LukaszWolf/Meteo-station-with-AWS-Cloud-5-semester-project-/docs/photos/IMG_20260125_191320.jpg

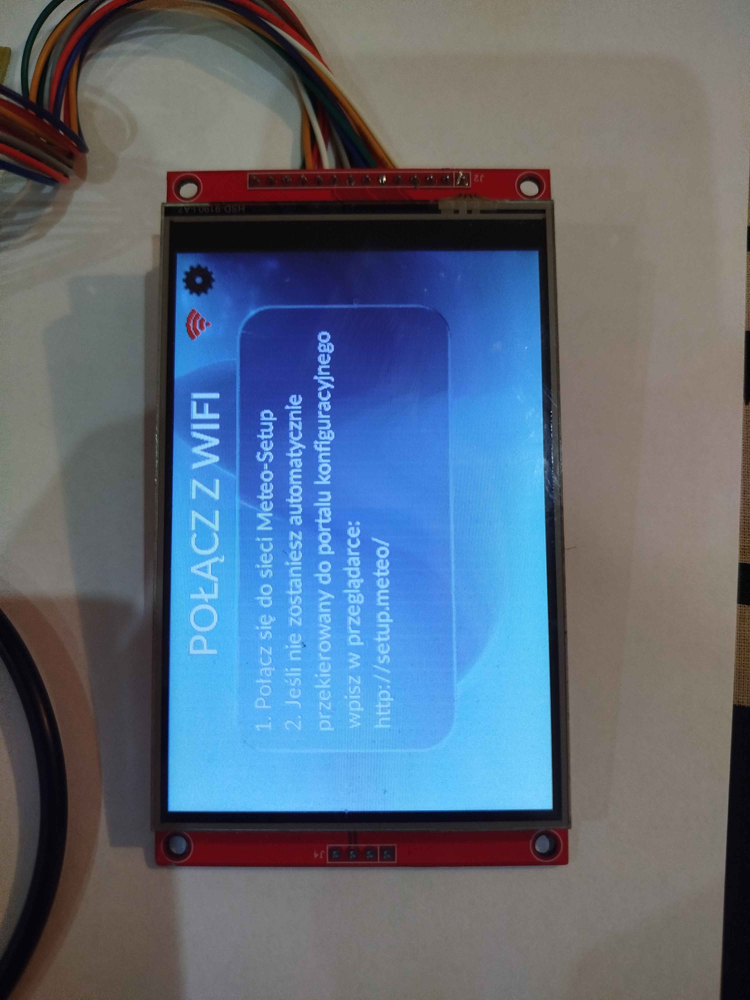
docs/photos/IMG_20260125_191320.jpg
