LukaszWolf/Meteo-station-with-AWS-Cloud-5-semester-project-/code/indoor module/data/images/app-connecting-screen-min.png

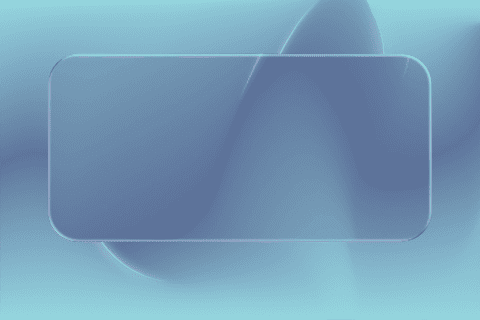
code/indoor module/data/images/app-connecting-screen-min.png
