LukaszWolf/Meteo-station-with-AWS-Cloud-5-semester-project-/code/indoor module/data/images/main_screen-min.png

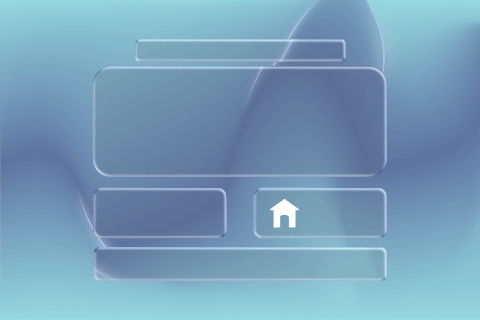
code/indoor module/data/images/main_screen-min.png
