LukaszWolf/Meteo-station-with-AWS-Cloud-5-semester-project-/code/indoor module/data/images/settings_screen-min.png

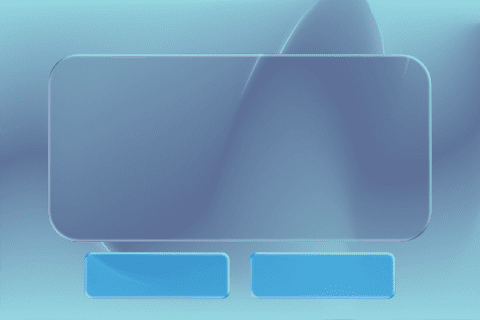
code/indoor module/data/images/settings_screen-min.png
