LukaszWolf/Meteo-station-with-AWS-Cloud-5-semester-project-/docs/photos/1769365940309.jpg

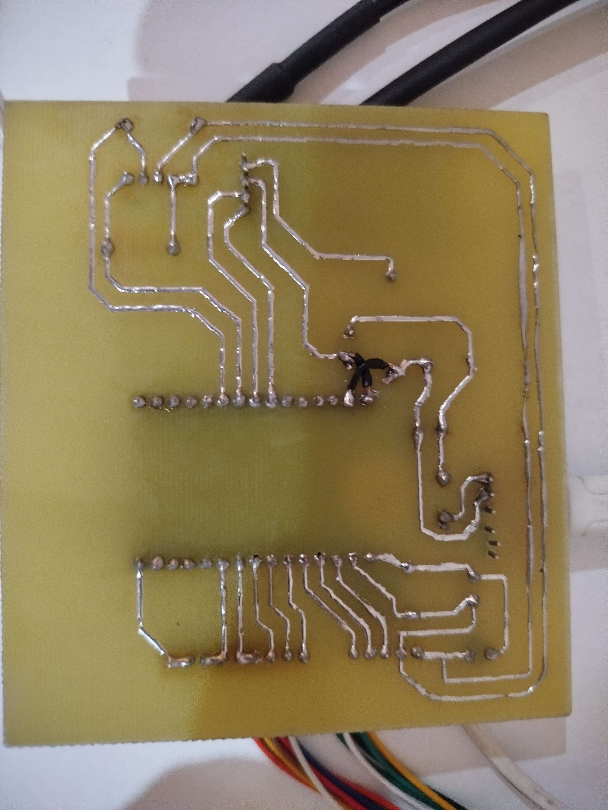
docs/photos/1769365940309.jpg
