LukaszWolf/Meteo-station-with-AWS-Cloud-5-semester-project-/docs/photos/IMG_20260125_190333.jpg

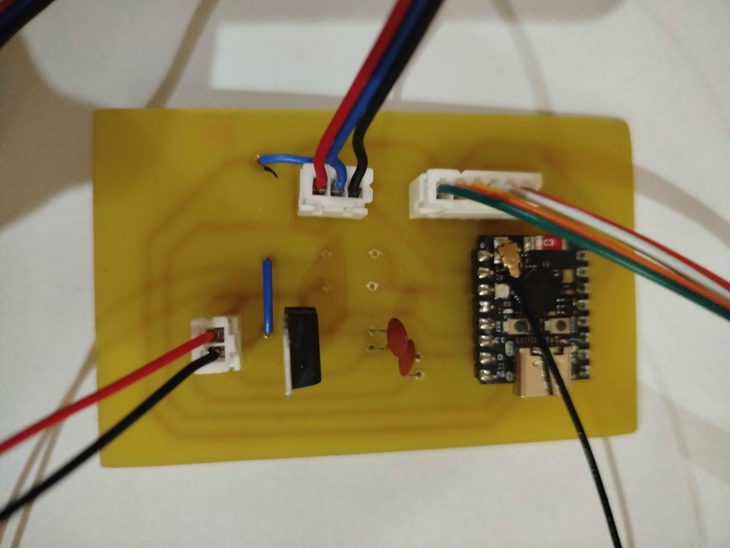
docs/photos/IMG_20260125_190333.jpg
