LukaszWolf/Meteo-station-with-AWS-Cloud-5-semester-project-/docs/photos/Zrzut ekranu 2026-01-25 192426.png

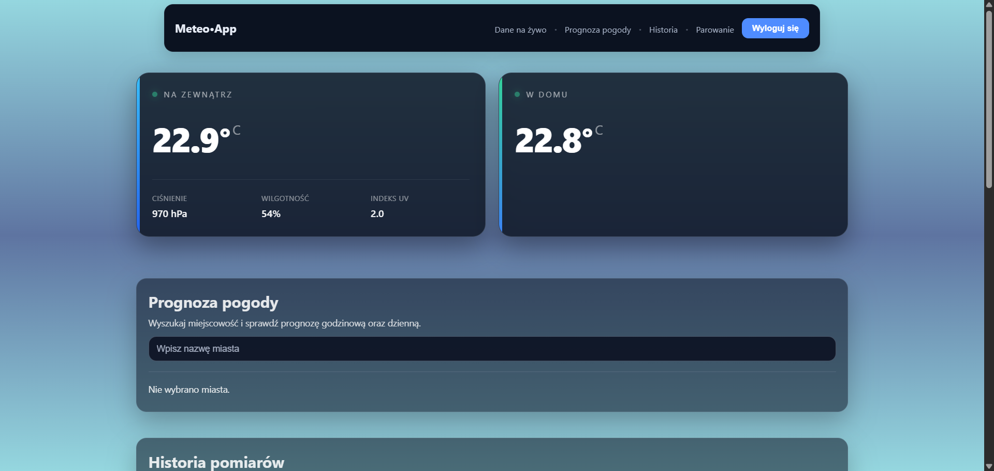
docs/photos/Zrzut ekranu 2026-01-25 192426.png
