LukaszWolf/Meteo-station-with-AWS-Cloud-5-semester-project-/docs/schemat ideowy modułu zewnętrznego.pdf

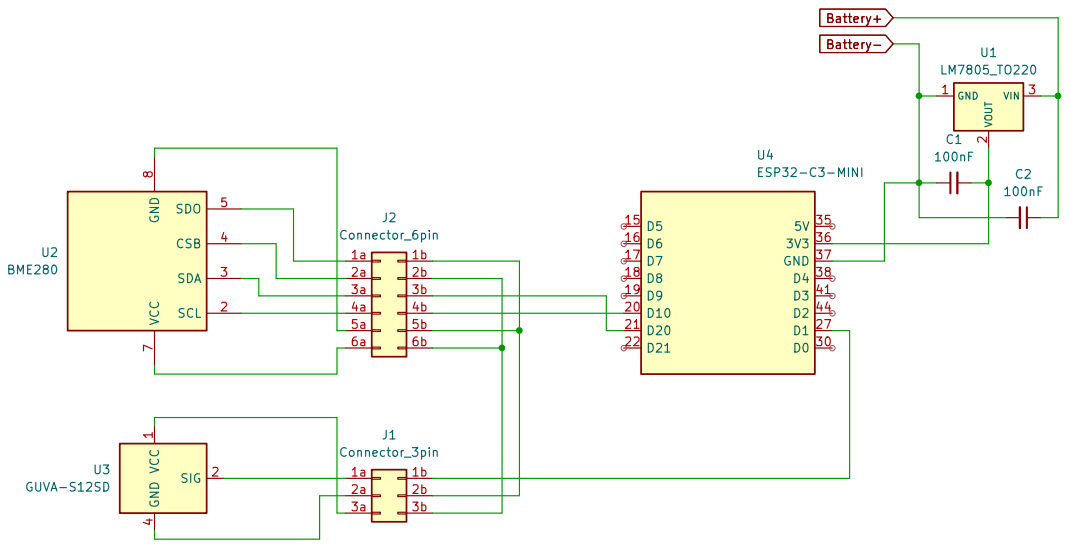
[picture p31: page 1]
