LukaszWolf/Meteo-station-with-AWS-Cloud-5-semester-project-/docs/schemat ideowy stacji domowej.pdf

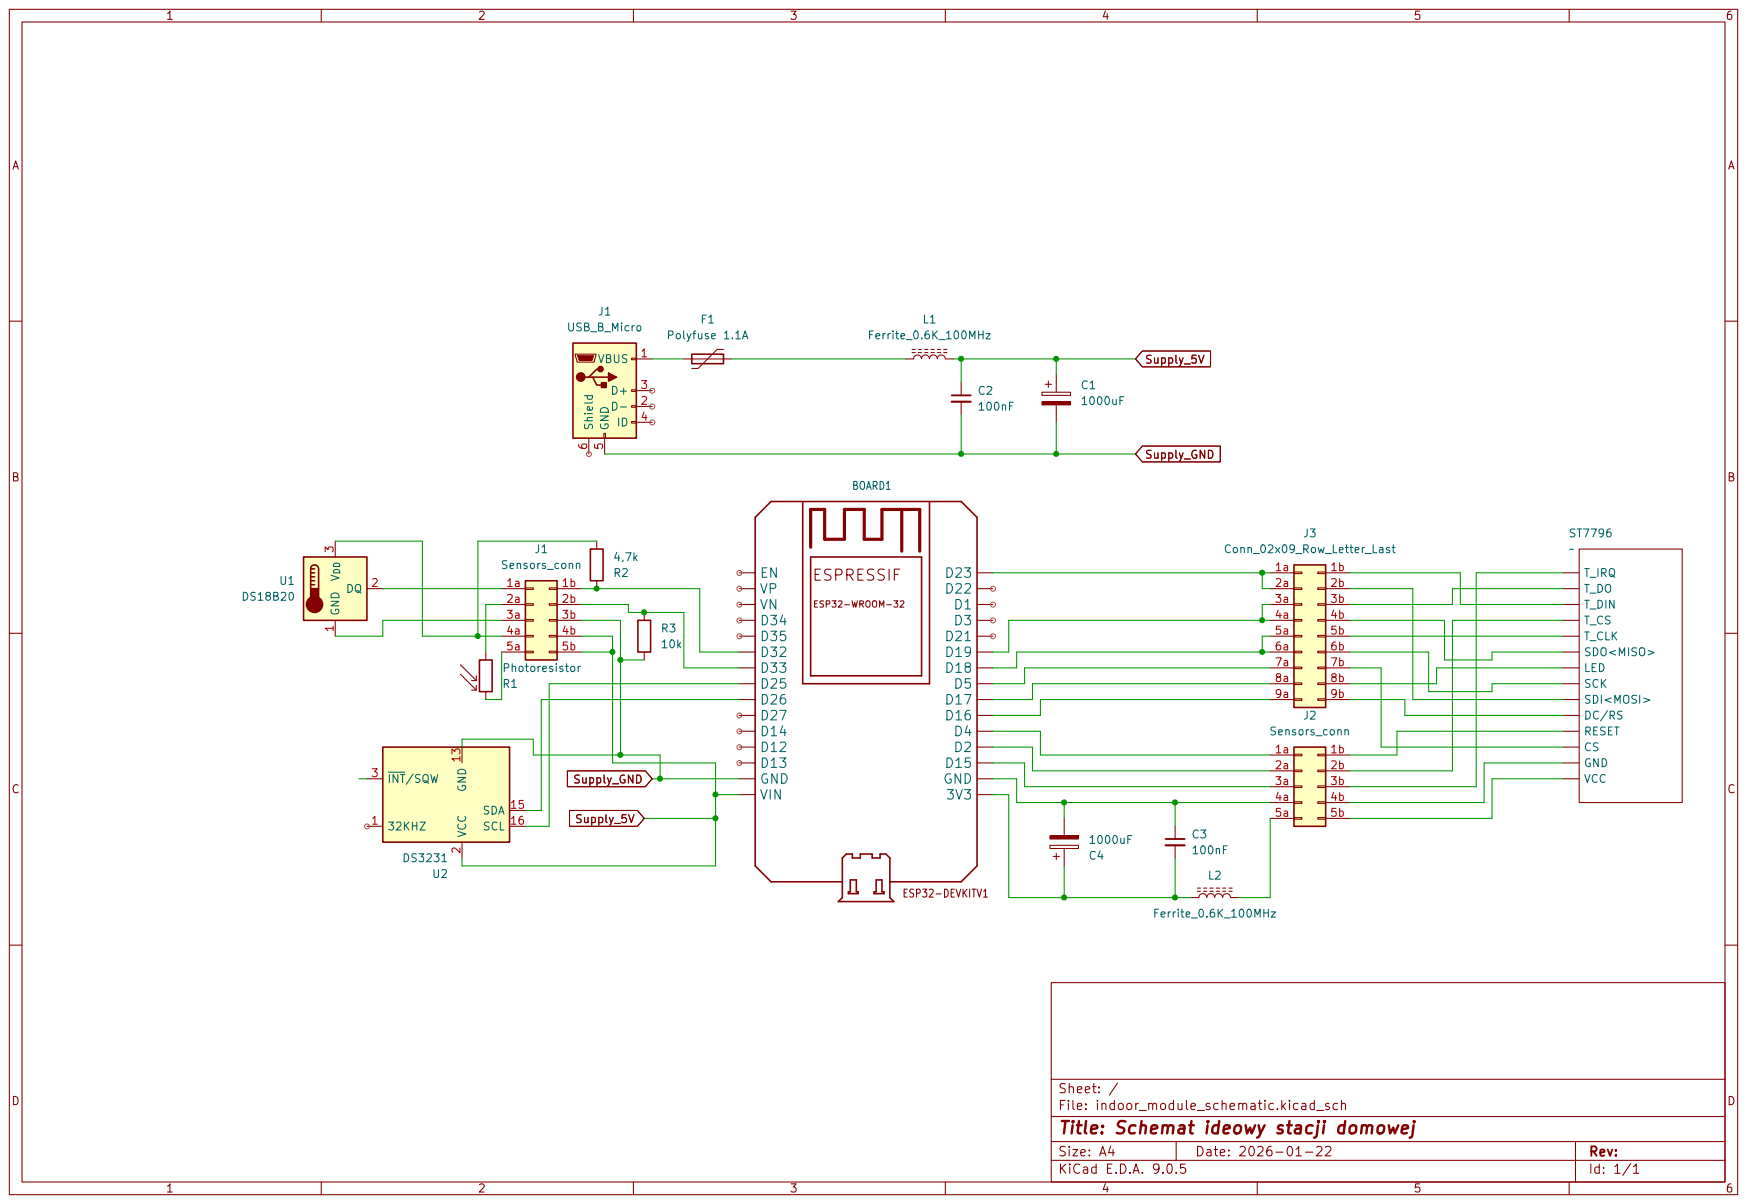
[picture p32: page 1]
