LukaszWolf/Meteo-station-with-AWS-Cloud-5-semester-project-/docs/schemat montażowy modułu zewnętrznego.pdf

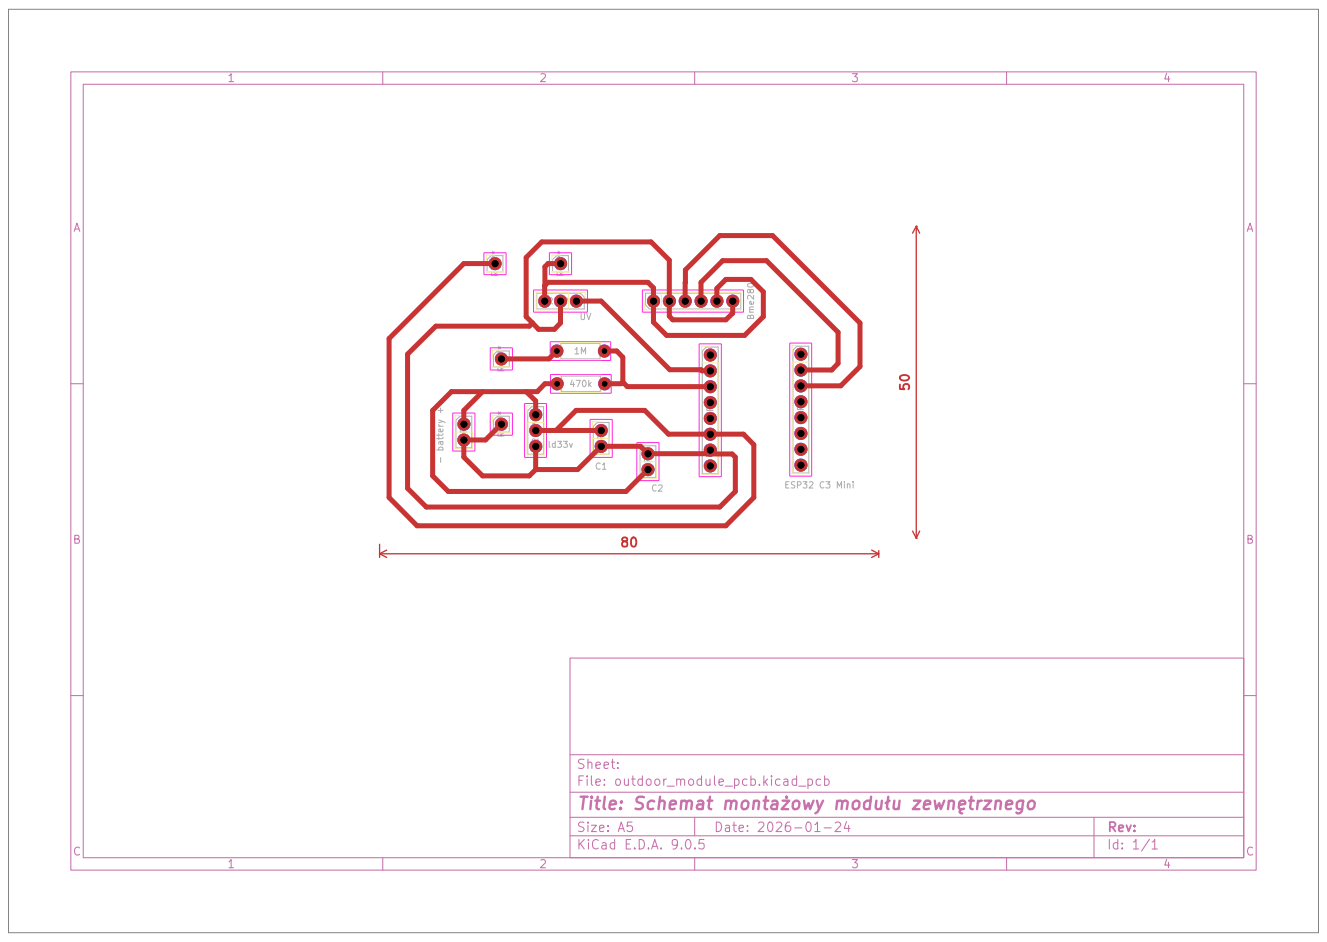
[picture p33: page 1]
