LukaszWolf/Meteo-station-with-AWS-Cloud-5-semester-project-/docs/schemat montażowy stacji domowej.pdf

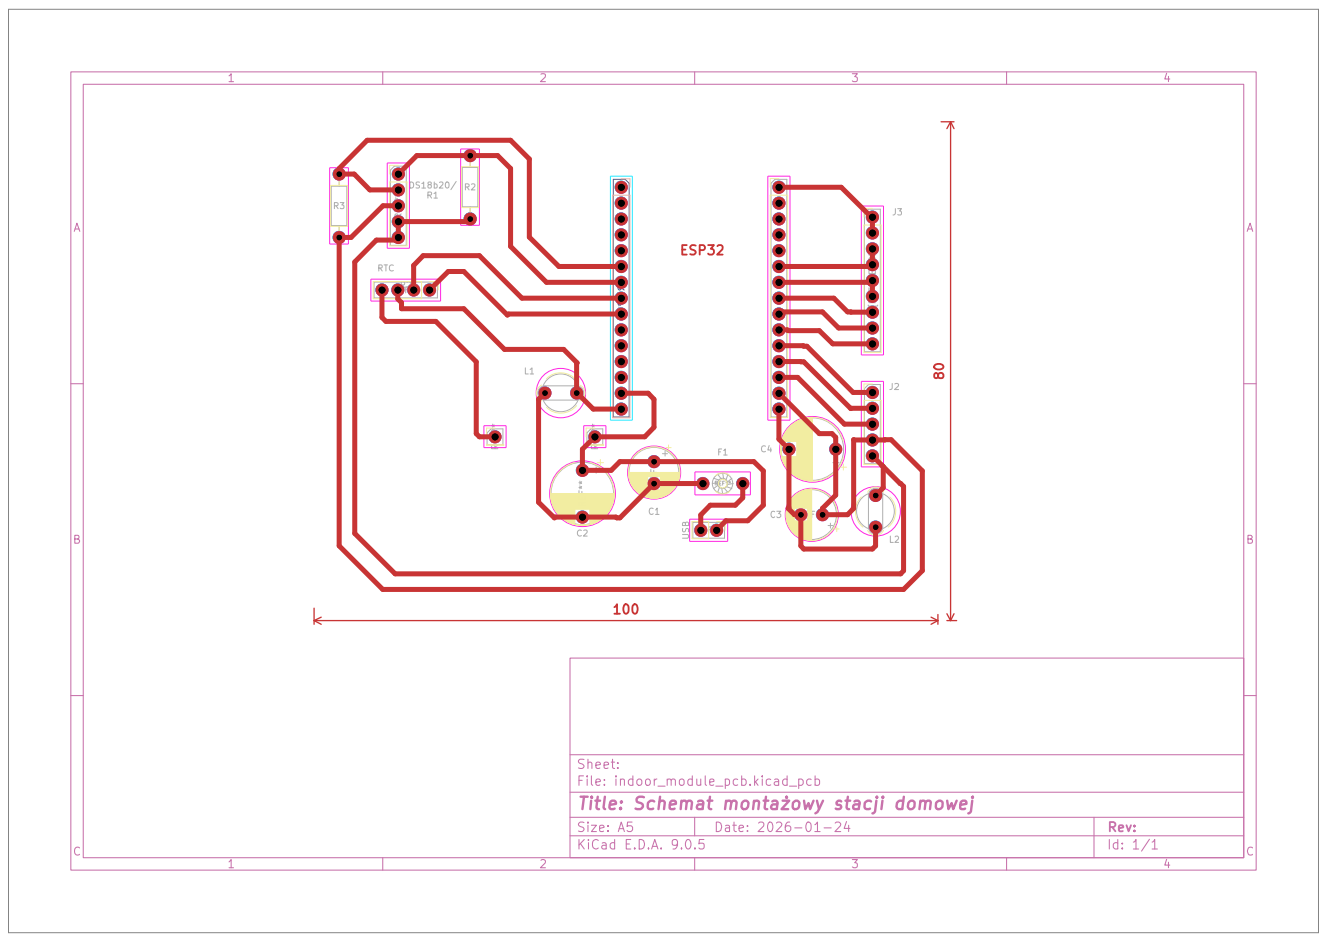
[picture p34: page 1]
