LukaszWolf/Meteo-station-with-AWS-Cloud-5-semester-project-/docs/hardware/indoor_module_schematic.kicad_sch

## KiCad design docs/hardware/indoor_module_schematic.kicad_sch (2026-01-18, last stored version)

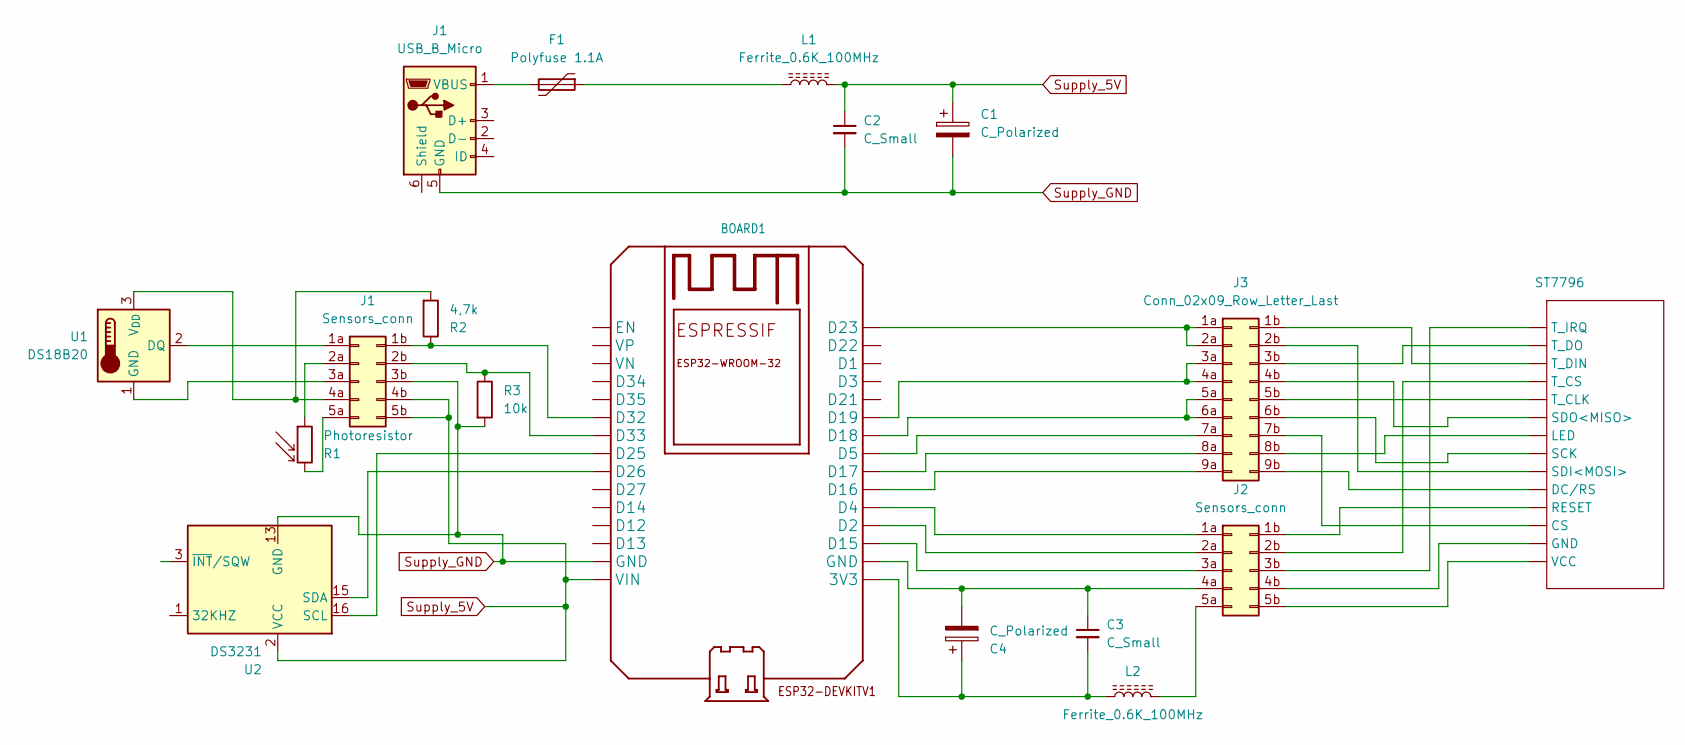
[picture p35: schematic indoor_module_schematic.kicad_sch]

Parts:
BOARD1: ESP32-DEVKITV1
C1, C4: C_Polarized
C2, C3: C_Small
F1: Polyfuse 1.1A
J1: USB_B_Micro
J2: Sensors_conn
J3: Conn_02x09_Row_Letter_Last
L1, L2: Ferrite_0.6K_100MHz
Photoresistor: R1; R_LDR_5.0x4.1mm_P3mm_Vertical
R2: 4,7k
R3: 10k
ST7796: (no value)
U1: DS18B20; TO-92_Inline
U2: DS3231

Connections:
unnamed: BOARD1.3V3, C3.2, C4.1, L2.1
unnamed: BOARD1.D2, J2.2a
unnamed: BOARD1.D4, J2.1a
unnamed: BOARD1.D5, J3.7a
unnamed: BOARD1.D15, J2.3a
unnamed: BOARD1.D16, J3.9a
unnamed: BOARD1.D17, J3.8a
unnamed: BOARD1.D18, J3.5a, J3.6a
unnamed: BOARD1.D19, J3.3a, J3.4a
unnamed: BOARD1.D23, J3.1a, J3.2a
unnamed: BOARD1.D25, U2.16 (SCL)
unnamed: BOARD1.D26, U2.15 (SDA)
unnamed: BOARD1.D32, J1.1b, R2.1
unnamed: BOARD1.D33, J1.2b, R3.1
unnamed: BOARD1.GND, C3.1, C4.2, J2.4a
unnamed: F1.1, L1.1
unnamed: F1.2, J1.1 (VBUS)
unnamed: J1.1a, U1.2 (DQ)
unnamed: J1.2a, Photoresistor.1
unnamed: J1.3a, U1.1 (GND)
unnamed: J1.4a, R2.2, U1.3 (V_{DD})
unnamed: J1.5a, Photoresistor.2
unnamed: J2.1b, ST7796.
unnamed: J2.2b, ST7796.
unnamed: J2.3b, ST7796.
unnamed: J2.4b, ST7796.
unnamed: J2.5a, L2.2
unnamed: J2.5b, ST7796.
unnamed: J3.1b, ST7796.
unnamed: J3.2b, ST7796.
unnamed: J3.3b, ST7796.
unnamed: J3.4b, ST7796.
unnamed: J3.5b, ST7796.
unnamed: J3.6b, ST7796.
unnamed: J3.7b, ST7796.
unnamed: J3.8b, ST7796.
unnamed: J3.9b, ST7796.
Supply_5V: BOARD1.VIN, C1.1, C2.1, J1.4b, J1.5b, L1.2, U2.2 (VCC)
Supply_GND: BOARD1.GND, C1.2, C2.2, J1.3b, J1.5 (GND), R3.2, U2.13 (GND)
